scornflake/WirelessButtons/sender/layout.md

Buttons
-------
Push buttons: 8                     = 8  
Up/Down switches (2 switches): 2    = 4
Buttons on Encoders: 2              = 2
Encoders: 2 (left/right switch)     = 4
Gear change: 2                      = 2

Total: 20
