scornflake/WirelessButtons/images/IMG_4715.jpg

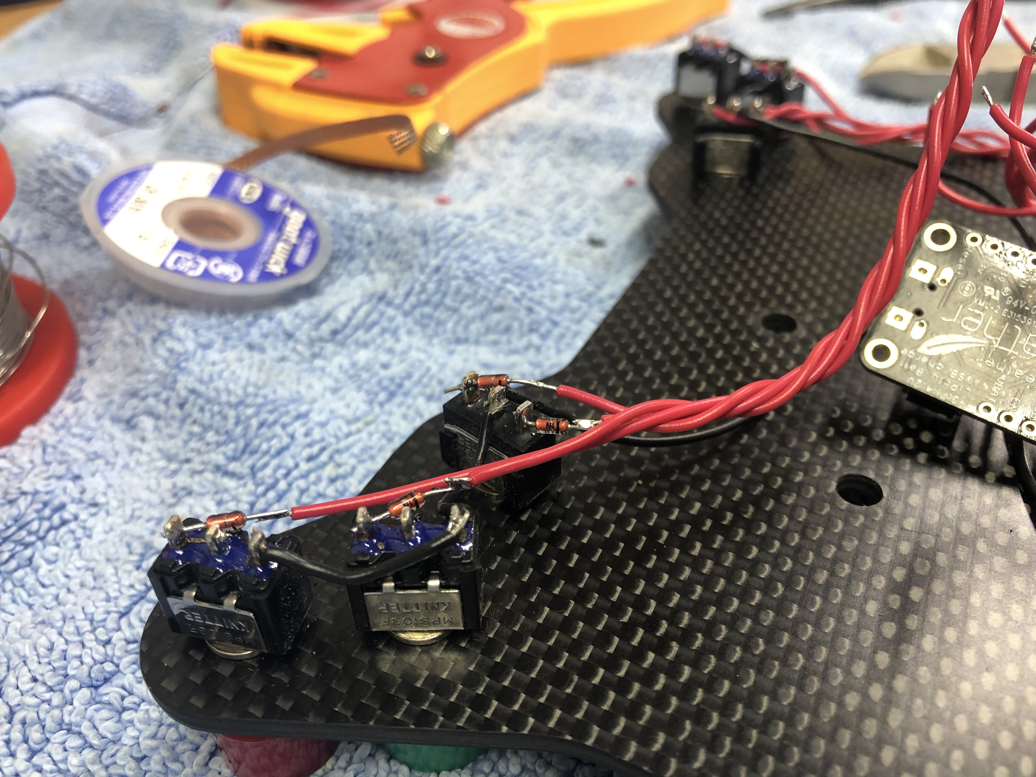
images/IMG_4715.jpg
