scornflake/WirelessButtons/images/IMG_4720.jpg

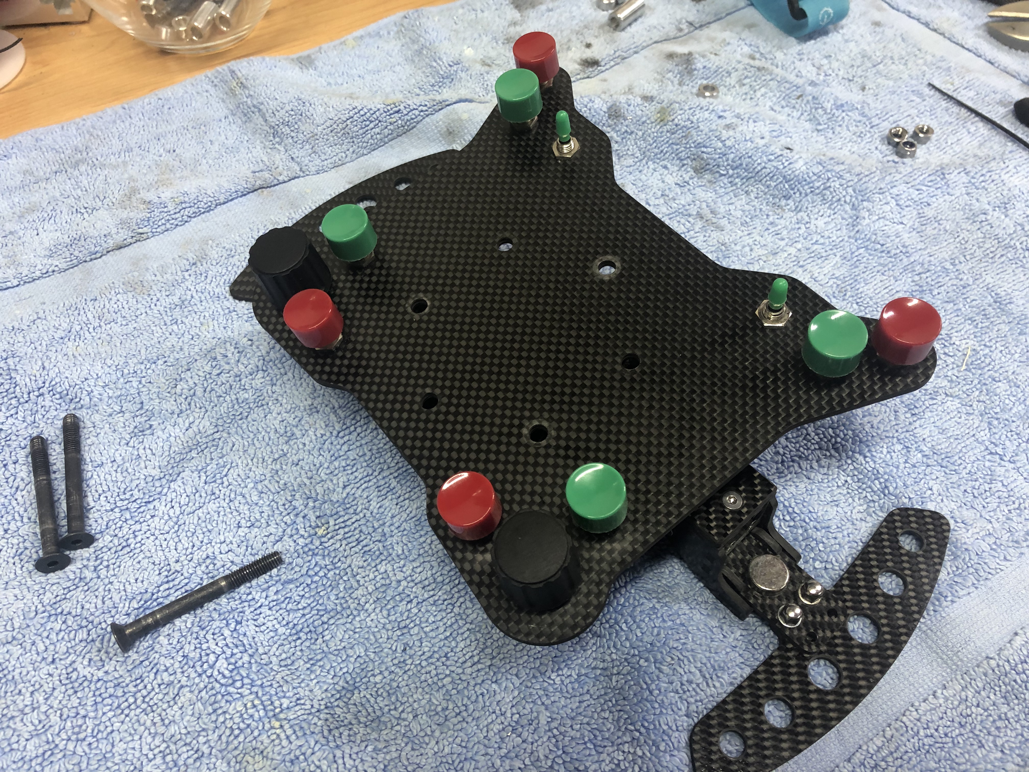
images/IMG_4720.jpg
