scornflake/WirelessButtons/images/IMG_4723.jpg

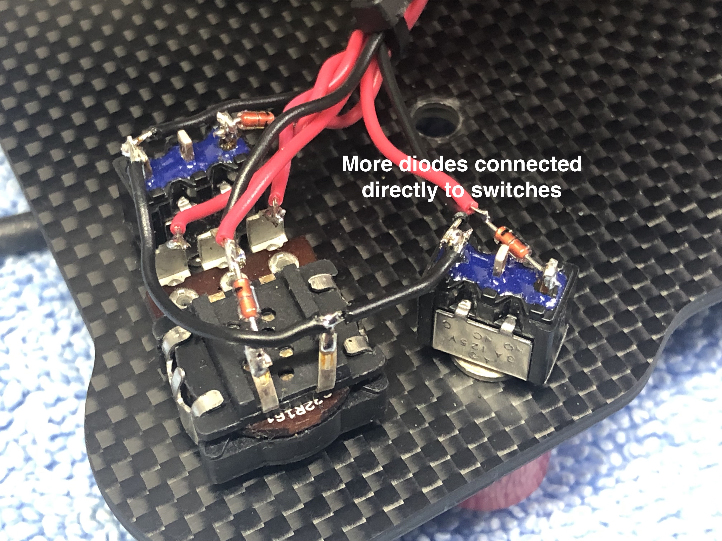
images/IMG_4723.jpg
