scornflake/WirelessButtons/(commit log)

2019-01-02 getting it working, on windows, with a button
2019-01-02 righteo, got it working for 24 buttons, attahced to real things
2019-01-06 turn keypad button pressing into HID state changes
2019-01-06 better macros that compute the right number of HID bytes (multiples of 8) get encoders going again, a wee more sensibly more debug output
2019-01-06 moved away from using the RX pin for a rotary encoder, causes issues on upload (depending on the encoder position) formatting, README
    [buttonplate.h, vars.h]
2019-01-06 no wires!
2019-01-06 encoder def in its own file now added battery monitoring added some RGB LED feedback for battary status more commenting of vars.h fixed compile regression
    [battery.h, buttonplate.h, encoder.h, mypixel.h, vars.h, wireless_button_sender.ino]
2019-01-06 adding power controller
2019-01-07 make it so that LEDs can be turned off battery LED can auto turn off after some ms time, and can be shown again by a 'held' button press
2019-01-07 always show light (it has virtually now power drain) separate #define to examine just the RGB status led
2019-01-07 advertise name over ScanResponse make power button better
2019-01-08 dont track this file
2019-01-08 split monitoring of battery level out to its own class separate from the LED refactored LED to inherit from color -> rgbled
2019-01-08 make default loop time 5ms so as to not saturate local BLE airspace make the loop() wait the remainder of the time in case it takes longer than the loop delay time
2019-01-09 don't always send packets, it tends to kill other BT devices (like, my mouse). added counters to show how many loops p/s & packets p/s
2019-01-14 make it possible to not use some of the pins of the RGB LED, because I'm running out of pinouts on my board! make power turn on automatically as soon as the sketch starts. add a very simple gate test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
2019-11-22 Using P channel FET
